ugursayar/r4_mecanum_base/r4_mecanum_base.ino

/*
 * r4_mecanum_base — Arduino Uno R4 WiFi mecanum rover driven by a Nesso N1 handheld.
 * ===========================================================================
 * The drive logic is a port of an earlier Arduino Uno Q build of the same chassis (not published), which
 * runs the same 4-wheel mecanum chassis on an Arduino Uno Q. What changed and why:
 *
 *   * TRANSPORT. The Uno Q build received NessoLink frames over the Router Bridge from a
 *     Linux MPU that owned the radio; there is no MPU here, so this sketch owns the
 *     link itself — Wi-Fi (UDP + TCP) and Bluetooth LE, auto-pairing with whichever
 *     remote speaks first. The dual-link state machine is taken from
 *     the NessoLink `Nesso_R4_Receiver` example.
 *   * NO VISION. The Uno Q build's MODE_AUTO chased objects detected by a camera on the
 *     MPU, gated by a host-side ARM toggle. Neither exists on a bare R4, so MODE_AUTO,
 *     the `vision`/`arm` streams and the arm-expiry failsafe are all gone. With nothing
 *     left to bind to the double-click gesture, mode selection loses its double-click
 *     window too — and with it the ~500 ms commit lag every mode change used to pay.
 *     The secondary stick and the throttle lock are ported in full (the Uno Q build
 *     2026-08-06): a second stick drives whichever everyday mode is NOT selected, so the
 *     two sticks span all three DOFs at once, and a long press locks the throttle axis
 *     instead of selecting a MODE_ROTATE that no longer exists.
 *   * BATTERY. The UPS_3S INA219 pack monitor IS ported (on A4/A5 here, D20/D21 there)
 *     and is INDICATOR-ONLY exactly as on the Uno Q build: it never cuts the motors and never
 *     shuts anything down. The pack's BMS remains the only automatic protection.
 *   * MATRIX. 12x8 here vs the Uno Q's 13x8, both read in PORTRAIT — px() applies the
 *     same 90 deg CW rotation, so an indicator ported from the Uno Q build keeps its geometry
 *     and only the height constant changes.
 *
 * Everything that IS drive logic is carried over unchanged in behaviour: the axis
 * dead-zone / stall-compensation split around the mecanum mix, the per-wheel mixer,
 * the proportional down-scale on overflow, the slew limiter, the click/hold mode
 * gestures and the stale-link stop.
 *
 * BOARD     : Arduino Uno R4 WiFi
 * LIBRARIES : WiFiS3 + Arduino_LED_Matrix (bundled with the R4 core),
 *             NessoLink (github.com/ugursayar/NessoLink),
 *             ArduinoBLE (only when ENABLE_BLE).
 *
 * BLE PREREQUISITES: an up-to-date ESP32-S3 modem firmware on the R4 plus ArduinoBLE.
 * Set ENABLE_BLE 0 for a Wi-Fi-only build with no ArduinoBLE dependency.
 */

#define ENABLE_BLE 1        // 0 = Wi-Fi only (no ArduinoBLE needed)
// TCP is OFF by default and should stay that way unless something actually needs it.
// WiFiS3's `WiFiServer::available()` is a SYNCHRONOUS modem round-trip that performs the
// accept on the ESP32-S3, so with no pending client it waits out the modem's timeout —
// **measured at ~10.1 s on this board**, on every single loop pass. That is 14x
// FAILSAFE_MS, so the rover stops, unpairs, re-pairs on the next buffered datagram and
// does it again 10 s later: with TCP polling on, a UDP link is unusable. The N1's Wi-Fi
// mode is UDP anyway. If TCP is ever needed it must be polled on a slow timer, or moved
// off the drive loop entirely — never called per pass.
#define ENABLE_TCP 0

#include "WiFiS3.h"
#include "Arduino_LED_Matrix.h"
#include <NessoFrame.h>     // portable codec; the library's WiFi transport classes are
                            // ESP32-only, so the Renesas MCU decodes packets itself
#include "arduino_secrets.h"
#include <Wire.h>
#include "INA219.h"         // UPS_3S pack monitor on A4/A5; absent is non-fatal
#include <string.h>
#include <stdlib.h>

#if ENABLE_BLE
#include <ArduinoBLE.h>
#endif

// ── Link config ───────────────────────────────────────────────────────────────
const char*    WIFI_SSID    = SECRET_SSID;
const char*    WIFI_PASS    = SECRET_PASS;
const uint16_t UDP_PORT     = 8889;    // firmware udp_port
const uint16_t TCP_PORT     = 8890;    // firmware tcp_port

// Nesso BLE Nordic-UART service (from the N1 firmware). We subscribe to TX (notify).
const char*    BLE_NAME     = "NESSO";
const char*    BLE_SVC_UUID = "6e400001-b5a3-f393-e0a9-e50e24dcca9e";
const char*    BLE_TX_UUID  = "6e400003-b5a3-f393-e0a9-e50e24dcca9e";

// Search dwell + failsafe timing. The PREFERRED transport gets the long window, the
// other a brief probe: the R4's BLE-central connect momentarily disrupts the N1's own
// Wi-Fi (the N1's C6 also shares one radio), so while unpaired we keep BLE probes short
// and infrequent. The preference is *sticky* — it follows whichever transport last
// paired us — so once you have driven over UDP the R4 stays biased to Wi-Fi.
#define SEARCH_PREFER_BLE 0             // cold-boot preference (0 = Wi-Fi first)
const uint32_t SEARCH_LONG_MS  = 15000; // dwell on the preferred transport
const uint32_t SEARCH_SHORT_MS = 4000;  // brief probe of the other transport
// Fruitless search windows after which the preference stops applying and BOTH transports
// get the long dwell. 2 = one full alternation: the preferred transport has had its long
// window and the other its short probe, and neither produced a frame — so the preference
// is now evidence about the past, not about where the remote is. See searchWindowMs().
const uint8_t  SEARCH_FAIR_AFTER = 2;
// Log any loop iteration slower than this. Sized below FAILSAFE_MS so a stall is reported
// before it is long enough to have dropped the link.
const uint32_t STALL_WARN_MS = 300;
// Reference for the stall detector, cleared by gotoState() so a transport hand-off is not
// reported: those legitimately block for seconds (enterWifi() waits on association, a
// failed BLE.begin() waits out the modem) and stop the motors FIRST, so they cost nothing
// the detector exists to catch. Only unexplained stalls should reach the log, or it becomes
// noise nobody reads.
uint32_t stallRefMs = 0;
// Paired: no valid frame for this long -> treat the link as dead and stop the rover.
// This is the Uno Q build's REMOTE_TIMEOUT (600 ms) rounded to the receiver's own 700 ms
// failsafe so the motors and the "no signal" display agree on when the link is gone.
const uint32_t FAILSAFE_MS     = 700;
const uint32_t UNPAIR_MS       = 3000;  // link lost this long -> re-enter search

// Declared up here, ahead of the first function definition in the file, because the
// Arduino preprocessor injects its auto-generated prototypes immediately before that
// point — a type used in a signature must already exist by then. The state machine that
// uses it lives further down with the transports.
enum LinkState { SEARCH_WIFI, SEARCH_BLE, PAIRED_WIFI, PAIRED_BLE };

ArduinoLEDMatrix matrix;

// ── Motors: 2x L298N, 4 MECANUM wheels, holonomic ─────────────────────────────
// One driver module per axle so the high-current leads stay short; the logic runs are
// the long ones, which is harmless at this PWM rate.
//
// PIN MAP IS IDENTICAL TO the Uno Q build's. That is deliberate and worth keeping: the same
// chassis and the same motor harness can be moved between the Uno Q and this board without
// re-terminating anything, and the two sketches' MOTORS[] tables can be read against each
// other line for line. Verified pin-by-pin against the R4 core before adopting:
//   * analogWrite() is only PWM on D3 D5 D6 D9 D10 D11 (confirmed in the UNOWIFIR4
//     variant's initVariant()) — on every other pin the core silently degrades it to a 0/1
//     digital write, so the four EN pins MUST come from that set. EN sits on
//     D5 D6 D9 D10, all four of which qualify.
//   * D0/D1 (Serial1) and A4/A5 (I2C) are untouched. A4/A5 carry the INA219 pack monitor.
//   * D10-D13 are the SPI bus and D3/D11 are PWM-capable; all are used as plain GPIO here.
//     Nothing on this board needs SPI, and spending a PWM-capable pin on a direction line
//     costs nothing.
//
// ONE R4-SPECIFIC DIFFERENCE, and the only place this map behaves unlike it does on the
// Uno Q: **D13 IS the built-in LED here** (PIN_LED = 13, port P102), whereas the Uno Q build's
// note records that D13 is *not* the onboard LED on an Uno Q. D13 is front-left's second
// direction pin, so the onboard LED now mirrors front-left's direction bit. That is
// cosmetic — the L298N input is high-impedance and the LED sits in parallel — but do not
// read that LED as a status light any more. The variant drives D13 LOW in initVariant()
// before setup() runs, so it boots to a defined state.
//
// Array order is {FL, RL, FR, RR} and must stay that way: drive4() indexes it
// positionally and the mecanum mix assigns a different expression to each corner.
// Reordering these silently turns a strafe into a spin. The order is a geometric fact
// about the chassis, unrelated to which module a motor is wired to.
//
// `inv` flips a motor's sense in software, exactly as swapping its two output leads
// would, so pin order stays natural (IN1 then IN2) on every entry — read the flag, not
// the pin order, to know which way a wheel turns. The values below are a STARTING
// GUESS, not a measurement: they assume the two sides are mirrored by mounting (so one
// whole side must be inverted for the rover to track straight) and that every motor is
// conventionally terminated. Four wheels turning the same absolute direction is the
// wrong state, not the right one — it drives one side backwards.
//
// BRING-UP, in this order — do not skip to the mix:
//   1. Set driveMode = MODE_WHEELTEST below, reflash, and check that the lit matrix
//      quadrant matches the wheel that actually spins. If not, reorder MOTORS[] — never
//      compensate in the mix. Driving forward is invariant to any permutation of the
//      four and rotating only distinguishes left from right, so a front/rear swap within
//      one side passes both those tests and corrupts nothing but strafe. This is the
//      only test that catches it.
//   2. Back in MODE_DRIVE, push the stick forward. Every wheel that turns backwards
//      gets its `inv` flipped. Now the rover tracks straight.
//   3. Only then check strafe, and if it goes the wrong way flip VX_SIGN — not `inv`,
//      which is by now calibrated for forward motion and would break driving straight.
struct Motor { uint8_t in1, in2, en; bool inv; };
// AS ACTUALLY BUILT (wiring confirmed 2026-08-06), and byte-for-byte the Uno Q build's table.
// **L298N#1 = REAR pair, L298N#2 = FRONT pair** — each module sits next to the motors it
// drives, so the high-current leads stay short and only the logic runs are long, which is
// harmless at this PWM rate.
//
// The two modules have OPPOSITE channel conventions: the REAR module is ch A = LEFT /
// ch B = RIGHT, but the FRONT module is ch A = RIGHT / ch B = LEFT. That is why the front
// pair below looks transposed against the rear pair — it is the wiring, not a slip.
//
// `inv` MEASURED on this build 2026-08-06 with MODE_WHEELTEST: all four wheels drove the
// corner the matrix lit (so the array order above is confirmed, and strafe has a correct
// foundation), and all four ran forward except front-right, which was flipped.
//
// The result is the clean symmetric case — the whole LEFT side inverted, the whole RIGHT
// side not — which is what a chassis whose sides are MIRRORED by mounting should give when
// every motor is conventionally terminated. Identical wiring spins mirrored motors in
// opposite *rover* directions, so one whole side must be inverted for the rover to track
// straight; four wheels turning the same absolute direction is the wrong state, not the
// right one.
//
// This is the one place the table DIVERGES from the Uno Q build, which needs front-right
// inverted too. That is not a difference in the chassis or the mix: the Uno Q build's
// front-right leads are terminated the other way round on OUT3/OUT4 relative to its other
// three, and that cable was re-terminated on this build before the R4 went in. `inv`
// belongs to the MOTOR, not the slot — it encodes how these leads are screwed into these
// terminals — so it does not travel with the pin map. If leads are ever re-terminated
// again, re-derive from a wheel test rather than stacking another inversion on top.
Motor MOTORS[4] = {
  {12, 13, 10, true },  // front-left   L298N#2(front)-B: IN3=D12, IN4=D13, ENB=D10 (~)
  { 2,  3,  5, true },  // rear-left    L298N#1(rear) -A: IN1=D2,  IN2=D3,  ENA=D5  (~)
  { 8, 11,  9, false},  // front-right  L298N#2(front)-A: IN1=D8,  IN2=D11, ENA=D9  (~)
  { 4,  7,  6, false},  // rear-right   L298N#1(rear) -B: IN3=D4,  IN4=D7,  ENB=D6  (~)
};

// Sign of the strafe axis as the CHASSIS sees it — RE-MEASURED 2026-08-11 after the
// wheels were remounted in their correct corners.
//
// The mecanum mix below assumes the standard X roller layout (viewed from above, the top
// rollers form an X: FL/RR at +45 deg, FR/RL at -45 deg). With the wheels mounted
// correctly this chassis IS that layout, so the sign is +1.
//
// History: this was -1, measured 2026-08-06 — but that measurement was taken with the
// mecanum wheels mounted in the WRONG corners, which mirrors the roller pattern the
// chassis presents. Remounting them flipped the strafe direction, and only the strafe:
// forward is invariant to roller orientation and rotation needed no change, which is
// exactly the signature of a roller-pattern flip rather than a wiring fault. The
// "this chassis's rollers are mirrored by design" story the old comment told was an
// artifact of the mis-mounted wheels — and the Uno Q build carries the same negation on the
// same chassis, so ITS -1 is suspect for the same reason and should be re-checked on
// hardware before being trusted again.
//
// One sign covers the diagonals as well, since the roller pattern is global. It lives
// HERE and nowhere else, which is what lets everything upstream — the matrix dot,
// dirName(), the serial log — read `vx` as "+ = the rover slides right".
//
// Do NOT "fix" a strafe fault with the `inv` flags: they are calibrated for forward motion
// and would break straight tracking.
const int VX_SIGN = +1;

// ── Drive tuning (PWM units, 0..255) ──────────────────────────────────────────
const int MIN_PWM   = 60;   // below this the motors stall; commands snap up to this
const int MAX_PWM   = 255;  // full speed available
// Belt-and-braces as of NessoLink 1.1.2, which makes "a released stick reads exactly 0"
// part of the contract — the N1 dead-zones its sticks before transmitting, confirmed on
// the Uno Q build's wire log 2026-08-06 (the L/R rest offset that read -12 for months now
// reads 0). Older handheld builds settled at +-11..14, and at a smaller deadband those
// counted as a command: the stall snap lifts them to MIN_PWM, and the shaping emits 0 or
// >=MIN_PWM and never anything between, so the rover kept creeping at ~65 PWM after the
// stick was let go until a release happened to land on 0. That was the "sometimes it
// won't stop" bug. Kept at 25 as the only cover against an out-of-date transmitter
// reintroducing it — the error is asymmetric (too wide only trims centre travel, too
// narrow lets the rover creep away). A non-zero rest reading now means a stale handheld
// build, not normal jitter.
const int REMOTE_DEADBAND = 25;   // applies to BOTH sticks — aux is the same -255..255 scale
const int SLEW_STEP       = 40;   // max PWM change per drive tick (smooth accel/brake ramp)
// The Uno Q build ran its whole loop at this period. Here the same period is a *timer*: the
// transport has to be polled continuously (there is no Bridge thread feeding frames in
// the background any more), and a blocking delay() long enough to matter drops UDP
// datagrams and starves the BLE stack. Driving on a tick keeps SLEW_STEP meaning what
// it meant — max PWM change per 60 ms — while the radio is serviced every pass.
const uint32_t DRIVE_TICK_MS = 60;

// ── Mecanum drive modes ───────────────────────────────────────────────────────
// The wheels are MECANUM, so the rover is holonomic: it can translate sideways without
// rotating. That needs all four wheels driven independently — a skid-steer mixer (both
// left wheels together, both right wheels together) cannot strafe at all, because
// strafing requires the front and rear wheels of one side to turn OPPOSITE ways. All
// four must therefore be working; one dead wheel does not merely weaken a strafe, it
// turns it into a veer.
//
// The N1's drive stick gives two axes and pre-mixes them into tank values, so a
// one-stick remote cannot reach all three DOFs at once — hence modes, cycled by the
// stick click, each re-using the same two axes for a different pair of DOFs. A N1 with a
// second stick fitted lifts exactly that limit (see SECONDARY STICK below), so modes are
// ONE-STICK machinery: with two sticks the mapping is fixed, the click cycle is disabled
// and the mode is pinned to DRIVE — the click then only serves the throttle-lock escape
// (and the WHEELTEST exit).
//
// MODE_WHEELTEST spins one wheel at a time in MOTORS[] index order and lights the matrix
// quadrant the code BELIEVES that index sits in — step 1 of bring-up above.
enum DriveMode : uint8_t { MODE_DRIVE = 0, MODE_STRAFE, MODE_WHEELTEST, MODE_COUNT };
// HOW THE MODES ARE SELECTED — one button, two gestures
//   single click  — clear the throttle lock if it is set (that is all it does); otherwise
//                   cycle the first MODE_CYCLE_COUNT modes: DRIVE -> STRAFE -> DRIVE, and
//                   from ANY off-cycle mode, back to DRIVE. So a click is always the way
//                   out of wherever a gesture put you, in exactly one step.
//   long press    — set the THROTTLE LOCK on the current mode (idempotent: holding again
//                   while locked is a no-op, not a toggle. "Hold = lock" is a simpler
//                   thing to remember mid-drive than a toggle whose result depends on
//                   where you already are, and the click out is unambiguous either way.)
//   reflash only  — MODE_WHEELTEST
// Only the two everyday driving modes are on the CYCLE, so clicking round can never land
// on anything that behaves unexpectedly; giving up an axis costs its own deliberate
// gesture. The off-cycle mode sits AFTER the cycled pair in the enum precisely so the
// cycle can be a prefix (`% MODE_CYCLE_COUNT`) — keep that ordering, and keep DRIVE at 0,
// since a click from an off-cycle mode falls back to it.
//
// MODE_ROTATE USED TO BE A MODE HERE and was replaced by the throttle lock, following
// the Uno Q build 2026-08-06. It was `vy = 0, w = turn` — which is DRIVE with the throttle
// forced to zero, i.e. one specific case of the lock. Generalising it costs nothing and
// gains the missing half: STRAFE with the throttle locked (slide sideways without
// creeping forward) had no way to be expressed before. The gesture, the idempotency and
// the click-out are all unchanged; what changed is that "hold" now means "drop the
// throttle axis" rather than "go to a particular mode", so it composes with the mode
// instead of replacing it. Nothing was lost: DRIVE + lock IS the old ROTATE, bit for bit.
//
// MODE_WHEELTEST keeps no gesture at all — it is reached by setting `driveMode`'s initial
// value below and reflashing. It ignores the stick and spins wheels on a timer, so
// landing on it mid-drive means the rover moves off with the stick centred; a bench
// diagnostic you need after rewiring should cost a reflash, not a slip of the thumb.
//
// The Uno Q build has a third gesture, the double click, which selects its vision mode. There
// is no vision here and nothing else worth a gesture, so the double click is gone — and
// with it the reason a single click had to sit in a 500 ms window before committing,
// waiting to find out whether a partner click was coming. Clicks commit on the release.
const uint8_t MODE_CYCLE_COUNT = 2;      // DRIVE, STRAFE — the click cycle, and only it
// How long the button must be held to count as a long press. Clear of a careless click
// below it, and eight link samples long — the N1 samples its buttons into a frame at
// ~10 Hz, so the threshold is never decided by one lucky frame.
const uint32_t LONGPRESS_MS  = 800;
const int      WHEELTEST_PWM = 200;      // pre-stallComp; brisk enough to be unmistakable
// Each wheel gets a SLOT, of which it spins for the first part and the rover is completely
// still for the rest. The gap is not padding — it is what makes "one wheel at a time"
// legible: without it you are watching for the moment one wheel stops and the next starts,
// and between FL and RL (both on the same side, a hand's width apart) that is exactly the
// distinction the test exists to resolve. With a still gap you count four unambiguous
// events instead.
const uint32_t WHEELTEST_MS      = 2000; // slot per wheel
const uint32_t WHEELTEST_SPIN_MS = 1400; // ...of which this much is spinning
const char*    WHEEL_NAMES[4] = { "FL front-left", "RL rear-left",
                                  "FR front-right", "RR rear-right" };
// Boot straight into the wheel-identification test. This is the ONLY way in — the test has
// no gesture on purpose, because it ignores both sticks and spins wheels on a timer, so
// landing on it mid-drive would mean the rover moves off with the sticks centred. A bench
// diagnostic you need after rewiring should cost a reflash, not a slip of the thumb. One
// click of the stick button leaves it for DRIVE (it is an off-cycle mode), so a paired
// remote can still escape without reflashing.
#define START_IN_WHEELTEST 0
uint8_t driveMode = START_IN_WHEELTEST ? MODE_WHEELTEST : MODE_DRIVE;
const NessoButton MODE_BUTTON = NESSO_BTN_STICK;   // click / hold — see above

// ── Throttle lock ─────────────────────────────────────────────────────────────
// Forces the forward/back axis to zero, leaving the mode's OTHER axis live. It is
// orthogonal to the mode rather than being one — hold in DRIVE and you can only rotate
// (the old MODE_ROTATE, exactly); hold in STRAFE and you can only slide sideways.
//
// Why it is worth a gesture at all: both are precision manoeuvres you can already perform
// by holding the throttle centred, and the lock just stops you creeping while you
// concentrate on the other axis. That is why it is a hold rather than a cycle position —
// useful when aiming, in the way when driving.
//
// It applies to the SUM of both sticks and is applied after the mix inputs are gathered.
// "Throttle locked" therefore means no forward motion can be commanded from anywhere,
// which is the only reading that keeps the matrix indicator honest — a second stick that
// could still drive forward would make the lock mean "locked, unless you use the other
// stick", which is not a lock.
bool throttleLock = false;

// ── Secondary stick: full holonomy with a FIXED mapping — no modes involved ───
// The N1 can carry up to three joysticks (drive seesaw + Mini JoyC + Unit JoyStick2).
// NessoLink carries the extras as aux stick 1 (auxX/auxY — present in v1 frames already,
// flagged by `hasAux`) and aux stick 2 (v2 frames only, `hasAux2`). This binds AUX
// STICK 1; aux stick 2 is decoded by the library but deliberately left unbound for now.
//
// With a second stick present the mapping is FIXED and does not depend on the mode:
//
//   primary stick (seesaw)     throttle + rotate  -> vy, w
//   secondary stick (aux 1)    throttle + strafe  -> vy, vx
//
// All three DOFs are live at once, so every motion in the README's reference chart —
// diagonals, strafe, and all four rotation types including the axle pivots — is
// available BY DEFAULT with no mode change. Modes exist only because ONE stick cannot
// express three DOFs; with two sticks there is nothing left to select, so DRIVE/STRAFE
// are one-stick machinery and a two-stick handheld pins the mode to DRIVE (see
// updateMode()). This port originally had the aux stick drive "whichever mode is not
// selected" instead — the same motions were reachable, but the sticks swapped roles
// when the mode changed, which bought nothing over a fixed mapping and made what a
// stick does depend on a dot on the matrix. Removed 2026-08-11.
//
// The THROTTLE LOCK composes with this: it zeroes vy after both sticks are summed, so
// lock + two sticks gives rotate on the primary and strafe on the secondary — two live
// axes, no forward creep.
//
// NESSO_BTN_STICK2 (the aux stick's own click) is deliberately left unbound — a second
// button that also changed state would make "which stick did I just click?" part of the
// answer, and the gesture set on the drive stick is already at its limit.
//
// The two sticks' contributions SUM and are then clamped, so the shared throttle axis
// adds where they agree and cancels where they fight. Cancelling is the honest result of
// a summed input and the only sane answer to two sticks commanding opposite throttles.
//
// `hasAux` is honoured rather than inferred from a non-zero reading: the encoder zeroes
// the aux fields, so 0/0 cannot distinguish "no stick" from "stick centred". Note the N1
// may ALREADY be setting it if a Mini JoyC is fitted — v1 has always had an aux slot — so
// this can change how an existing handheld drives, not just a future one.
//
// AXIS CONVENTION — specified by the protocol, so this file makes no assumptions.
// NessoLink 1.1.2 states it normatively (see the library's NessoFrame.h): every axis in
// the frame, motors and aux alike, is -255..255; `auxX` is screen-HORIZONTAL with
// positive = RIGHT; `auxY` is screen-VERTICAL with positive = UP. A released stick reads
// exactly 0 — the transmitter applies its own dead zone. "Screen-relative" means the
// TRANSMITTER has already normalised for its display orientation and for how each stick
// module is physically mounted, so this end just reads right/up and does nothing else:
// no sign flip, no swap, no rescale, and deliberately no AUX_X_SIGN / AUX_Y_SIGN knob.
//
// That contract was written down *because* the Uno Q build got it wrong first. Before 1.1.2
// the header specified no aux range and no axis convention, so both had to be guessed —
// and both guesses were wrong: the N1 was transmitting the axes TRANSPOSED (pushing the
// stick up strafed the rover right), because its aux path skipped the orientation flags
// its drive path applied, and its own on-screen joystick disc rendered from the same
// transposed pair — so the handheld looked correct while the wire was swapped. It was
// also sending aux at +-515, the joystick module's raw ADC span, against +-255 for the
// motors. Both were fixed in the TRANSMITTER, not in any receiver: a receiver cannot know
// how a handheld's modules are mounted, so compensating locally would have left every
// other NessoLink receiver still swapped and would have inverted this one the moment the
// transmitter was fixed. Same rule as VX_SIGN in the mix — a correction belongs where the
// fact it corrects lives. If an axis is wrong, fix the transmitter.


// ── Link state ────────────────────────────────────────────────────────────────
// (enum LinkState is declared with the link config at the top — see the note there.)
LinkState linkState      = SEARCH_WIFI;
uint32_t  stateEnteredMs = 0;
uint32_t  lastFrameMs    = 0;
bool      preferBle      = SEARCH_PREFER_BLE;  // sticky: follows the last transport that paired

// Length of the current search window — the preferred transport dwells longer.
// Search windows completed since the last successful pair. Resets in acceptFrame().
uint8_t searchRounds = 0;

uint32_t searchWindowMs() {
  // THE PREFERENCE DECAYS. It is a tie-breaker for the first couple of windows, not a
  // standing bias — because the thing it is biased toward is whatever worked LAST time,
  // and the most common reason a paired link stops is that the operator moved the handheld
  // to the OTHER transport. Held indefinitely, the preference then votes for the transport
  // that just went away: after pairing over BLE it gave BLE 15 s and Wi-Fi only 4 s, and
  // that 4 s had to cover a possibly-slow reconnect before any listening could happen.
  // Observed on hardware 2026-08-06 — switching the N1 from BLE to Wi-Fi UDP did not
  // reconnect at all until the R4 was power-cycled (which cleared preferBle to its
  // cold-boot default).
  //
  // So once both transports have had their turn and neither produced a frame, stop
  // favouring and give each a full window. The fast re-pair on the usual transport is
  // preserved for the case it is meant for — a brief dropout on the SAME transport, which
  // is resolved inside the first window or two.
  if (searchRounds >= SEARCH_FAIR_AFTER) return SEARCH_LONG_MS;
  bool onWifi = (linkState == SEARCH_WIFI);
  return (onWifi != preferBle) ? SEARCH_LONG_MS : SEARCH_SHORT_MS;   // preferred -> long
}

// ── Shared drive state, written by whichever transport delivered the frame ────
int      remoteL = 0, remoteR = 0;
int      remoteAuxX = 0, remoteAuxY = 0;   // aux stick 1; -255..255, +X = right, +Y = up
bool     remoteHasAux = false;
uint16_t remoteBtns = 0;
bool     haveFrame = false;

// Bound Wi-Fi remote (source-lock): once paired we only trust this origin.
IPAddress boundIp(0, 0, 0, 0);
char      pairLabel[24] = "";

static inline bool isPaired() { return linkState == PAIRED_WIFI || linkState == PAIRED_BLE; }

// ── Motor primitives ──────────────────────────────────────────────────────────
// Shape a raw remote axis onto the usable band. The dead-zone and the MIN_PWM stall snap
// happen on OPPOSITE sides of the mecanum mix, which is why this is two functions and
// not one:
//   * axisDead() runs on the INPUT axes. Rescales [DEADBAND..full] -> [0..255] linearly.
//   * stallComp() runs on each mixed WHEEL value. Rescales [1..255] -> [MIN_PWM..MAX_PWM].
// Snapping to MIN_PWM before mixing would be wrong: it would inject a 60-unit floor into
// every axis, so a pure-forward command would leak a phantom strafe/rotate term and the
// rover would crab instead of tracking straight.
int axisDead(int v) {
  int s = (v < 0) ? -1 : 1, m = abs(v);
  if (m <= REMOTE_DEADBAND) return 0;
  long out = (long)(m - REMOTE_DEADBAND) * 255 / (255 - REMOTE_DEADBAND);
  return s * (int)out;
}
// Clamp an AXIS — not a wheel value — to the -255..255 band that the mecanum mix, the
// matrix dot and dirName() all assume. Needed once two sticks can feed the same axis: a
// summed throttle reaches +-510, which would push showDir()'s dot off the panel and hand
// the ratio between the axes to the wheel-overflow rescale below instead of to the
// operator. Used on the raw aux input too, where it is a MALFORMED-FRAME GUARD and not a
// rescale — the field is int16, so a bad or hostile frame could otherwise inject +-32767
// into the mix, which the wheel-overflow rescale would treat as a legitimate full-scale
// command and divide every other axis down against. It is a no-op for anything in spec.
int clampAxis(int v) { return (v > 255) ? 255 : ((v < -255) ? -255 : v); }
int stallComp(int v) {
  if (v == 0) return 0;
  int s = (v < 0) ? -1 : 1, m = abs(v);
  if (m > 255) m = 255;
  long out = (long)(m - 1) * (MAX_PWM - MIN_PWM) / 254 + MIN_PWM;
  return s * (int)out;
}
int slew(int cur, int target) {             // ramp cur toward target by at most SLEW_STEP
  if (target > cur) return (target - cur > SLEW_STEP) ? cur + SLEW_STEP : target;
  if (target < cur) return (cur - target > SLEW_STEP) ? cur - SLEW_STEP : target;
  return cur;
}
void setMotor(const Motor& m, int v) {
  if (v > 255) v = 255; if (v < -255) v = -255;
  if (m.inv) v = -v;             // clamp first: -(-255) is in range, -(-256) would not be
  if (v >= 0) { digitalWrite(m.in1, HIGH); digitalWrite(m.in2, LOW); }
  else        { digitalWrite(m.in1, LOW);  digitalWrite(m.in2, HIGH); v = -v; }
  analogWrite(m.en, v);
}
// Per-wheel, not per-side: a drive(left, right) mixer feeds both left wheels the same
// value and both right wheels the same value, which is skid steer and can never strafe.
// Index order matches MOTORS[]: {FL, RL, FR, RR}.
void drive4(const int w[4]) {
  for (int i = 0; i < 4; i++) setMotor(MOTORS[i], w[i]);
}

int curPwm[4] = {0, 0, 0, 0};   // last values written; the slew limiter's state

// Cut the motors NOW, skipping the ramp, and forget where the ramp had got to. Called
// before anything that stops servicing the drive tick — every transport transition takes
// the radio down and enterWifi() blocks for up to nine seconds, during which the last
// PWM values would otherwise stand. A ramp is a comfort feature for a rover under
// command; a rover whose commands have stopped arriving should not be ramping anywhere.
void stopMotors() {
  const int zero[4] = {0, 0, 0, 0};
  drive4(zero);
  for (int i = 0; i < 4; i++) curPwm[i] = 0;
}

// ── LED matrix — PORTRAIT, rotated 90 deg CW on the way out ───────────────────
// The panel is physically 12 columns x 8 rows landscape, but the rover is read with the
// board turned, so every routine below draws in a LOGICAL 8x12 PORTRAIT frame and px()
// applies the rotation. Logical (0,0) is the TOP-LEFT as seen by the viewer, +x is right
// and +y is DOWN. Nothing above fbRender() should touch fb[][] directly.
//
// This is the same arrangement the Uno Q build uses (its panel is 13x8, so its logical frame
// is 8x13); keeping the two in the same orientation means an indicator ported from there
// keeps its geometry and only its height constant changes.
//
// The frame is banded, and the bands do not overlap:
//   y = 0        STATUS   — link + mode                        (showDir)
//   y = 2..H-3   STICK    — the proportional dot; its plus spans y = 1..H-2
//   y = H-1      BATTERY  — pack gauge                         (showDir)
const int PANEL_ROWS = 8, PANEL_COLS = 12;   // physical
const int W = 8, H = 12;                     // LOGICAL, post-rotation: 8 wide, 12 tall
uint8_t fb[PANEL_ROWS][PANEL_COLS];
uint8_t lastFB[PANEL_ROWS][PANEL_COLS];
bool    haveLast = false;

// Which way the panel is turned relative to the logical frame. 1 = the 90 deg CW mapping
// the Uno Q build uses; 0 = the other way round. This is a PHYSICAL fact about how the board is
// mounted on the rover, so it lives in exactly one place — like VX_SIGN. If the whole
// display comes out upside down (status row along the wrong edge, forward reading as
// backward), flip THIS, never the individual draw routines: they are all in logical
// coordinates and are correct relative to each other.
#define MATRIX_ROTATE_CW 1

static inline void fbClear() { memset(fb, 0, sizeof(fb)); }
// Logical -> physical. CW: logical +x (right) becomes physical +row and logical +y (down)
// becomes physical -col. W is the physical row count and H the physical column count,
// which is why the logical frame is 8x12 and not 12x8.
static inline void px(int x, int y) {
  if (x < 0 || x >= W || y < 0 || y >= H) return;
#if MATRIX_ROTATE_CW
  fb[x][H - 1 - y] = 1;
#else
  fb[W - 1 - x][y] = 1;
#endif
}
void fbRender() {
  if (haveLast && memcmp(fb, lastFB, sizeof(fb)) == 0) return;   // skip identical redraws
  matrix.renderBitmap(fb, PANEL_ROWS, PANEL_COLS);
  memcpy(lastFB, fb, sizeof(fb));
  haveLast = true;
}

// Proportional "virtual stick" indicator: a plus-shaped dot whose position encodes
// throttle (up = forward) and lateral command (right = right); dead-centre = stopped.
// The horizontal axis shows whichever DOF the current mode steers with, so the dot keeps
// meaning "where the stick is" in every mode. That relies on `vx` and `w` both being in
// the OPERATOR's frame (+ = right) all the way down to here — the chassis's roller
// mirroring is applied in the mix via VX_SIGN, not to the axes.
//
// TOP ROW (y=0) — connection on the left, mode on the right:
//   x=0 lit = paired over Wi-Fi,  x=1 lit = paired over BLE
//   right edge = mode, 1..MODE_COUNT dots from x=W-1 leftwards:
//               1 = DRIVE, 2 = STRAFE, 3 = WHEELTEST
// Three dots stop at x=5, so the two groups can never run together.
//
// BOTTOM ROW (y=H-1) — battery gauge, 1..W pixels. Always lights at least one pixel while
// the INA219 is readable, so an EMPTY bottom row means "no sensor" and never "flat pack".
// Those are opposite states: a missing sensor deliberately disables battery management and
// leaves the rover driving, so they must not look alike.
//
// The THROTTLE LOCK is drawn by changing the dot's SHAPE rather than by claiming another
// pixel: locked, it loses its vertical arms and becomes a horizontal bar. That is the
// indicator describing itself — the arms it drops are the axis it gave up — and it reads
// at a glance from the shape alone, which a lone extra status pixel would not. It also
// cannot be confused with "throttle merely centred": that is a plus sitting on the centre
// row, this is a bar.
void showDir(int vy, int vx, int w, bool viaBle, uint8_t mode, bool lock,
             float pct, bool battOk, bool lowWarn) {
  fbClear();

  // TOP ROW — link + mode
  px(viaBle ? 1 : 0, 0);
  for (uint8_t i = 0; i <= mode && i < MODE_COUNT; i++) px(W - 1 - i, 0);

  // BOTTOM ROW — battery gauge
  if (battOk) {
    int cols = 1 + (int)(pct / 100.0f * (W - 1) + 0.5f);
    if (cols > W) cols = W;
    if (cols < 1) cols = 1;
    for (int i = 0; i < cols; i++) px(i, H - 1);
  }
  // Low-battery blink at the far end of the gauge row. It only collides with the gauge
  // itself at ~100% charge, which cannot be true while the warning is latched.
  if (lowWarn && (millis() / 500) % 2) px(W - 1, H - 1);

  // MIDDLE BAND — the stick dot. The centre is clamped to y = 2..H-3 so the plus can
  // never bleed into the status row above or the battery row below.
  int lat = (vx != 0) ? vx : w;               // -255..255  right(+) / left(-)
  int x   = (lat + 255) * (W - 1) / 510;      // 0..W-1
  int y   = 2 + (255 - vy) * (H - 5) / 510;   // 2..H-3  (forward = top)
  px(x, y); px(x - 1, y); px(x + 1, y);              // horizontal bar — always
  if (!lock) { px(x, y - 1); px(x, y + 1); }         // vertical arms — only unlocked
  fbRender();
}

// Light the 3x3 quadrant matching MOTORS[idx]'s *assumed* corner, while that wheel — and
// only that wheel — spins. If the lit corner and the spinning wheel disagree, the array
// order is wrong and strafe cannot work; fix the order, never the mecanum signs.
void showWheelTest(int idx) {
  fbClear();
  int x0 = (idx == 0 || idx == 1) ? 0 : W - 3;   // {FL,RL} left  | {FR,RR} right
  int y0 = (idx == 0 || idx == 2) ? 0 : H - 3;   // {FL,FR} front | {RL,RR} rear
  for (int dx = 0; dx < 3; dx++)
    for (int dy = 0; dy < 3; dy++) px(x0 + dx, y0 + dy);
  fbRender();
}

// Blinking battery outline with a proportional fill — shown instead of the stick dot once
// the pack is critically low, so the state is unmistakable from across the room. It takes
// the whole panel, status and gauge rows included: at this point there is nothing more
// important for the panel to be saying.
void showBattery(float pct) {
  fbClear();
  if ((millis() / 500) % 2) {
    px(3, 0); px(4, 0);                                              // terminal (top)
    for (int x = 1; x <= 6; x++) { px(x, 1); px(x, H - 1); }          // body top/bottom
    for (int y = 1; y <= H - 1; y++) { px(1, y); px(6, y); }          // body sides
    int rows = (int)(pct / 100.0f * (H - 3) + 0.5f);                  // interior y = 2..H-2
    if (rows > H - 3) rows = H - 3;
    for (int i = 0; i < rows; i++)                                    // fills from the bottom
      for (int x = 2; x <= 5; x++) px(x, H - 2 - i);
  }
  fbRender();
}

// Searching animation. Top block lit on the left = scanning Wi-Fi, on the right = BLE.
// A short bar sweeps DOWN the tall axis below it.
void drawSearch(bool ble) {
  fbClear();
  if (!ble) { for (int x = 0; x < 3; x++) px(x, 0); }
  else      { for (int x = W - 3; x < W; x++) px(x, 0); }
  int sweep = 2 + (int)((millis() / 120) % (H - 3));
  px(3, sweep); px(4, sweep);
  fbRender();
}

// Link-loss indicator: a full-panel X. The rover is stopped whenever this is showing.
void drawNoSignal() {
  fbClear();
  for (int y = 0; y < H; y++) {
    int x1 = y * (W - 1) / (H - 1);
    px(x1, y);
    px(W - 1 - x1, y);
  }
  fbRender();
}

// ── Battery: UPS_3S (3x 18650 in series) via INA219 @ 0x41 on Wire (A4/A5) ────
// Ported from the Uno Q build 2026-08-06, thresholds and state machine unchanged.
//
// Thresholds are on the *pack* voltage (bus + shunt drop), smoothed by an EMA: the motors
// draw from the same pack, so a stall sags the rail well below the true state of charge.
// tau ~= 20 s at 1 Hz rides out any sag short of an actually flat battery, so a brief sag
// can never trip the display while a real decline still shows within ~30 s.
//
// INDICATOR-ONLY, exactly as on the Uno Q build: this does NOT cut the motors and does not shut
// anything down. The pack's own BMS is the only automatic protection. The consequence,
// stated plainly because it is a real trade: a flat pack under motor load will be dragged
// to BMS cutoff if the operator ignores the panel.
//
// The failsafe direction here is the OPPOSITE of the link's, deliberately. An absent or
// failed INA219 reports state -1 and leaves the rover driving, because losing a *sensor*
// must not immobilise the rover — whereas losing contact with the *operator* must never
// leave it driving. Do not "make them consistent".
INA219 ina;

const float V_MIN     = 9.0f;    // 3.0 V/cell — pack empty (0 %)
const float V_MAX     = 12.6f;   // 4.2 V/cell — pack full (100 %)
const float V_WARN    = 9.6f;    // ~17 % — advisory only (blinking gauge-row pixel)
const float V_CRIT    = 9.3f;    // ~8 %  — full-panel battery display; no action taken
const float V_RELEASE = 10.5f;   // critical latch clears only once clearly recharged
const float WARN_HYST = 0.15f;   // warn releases at V_WARN + this

const uint32_t BATT_SAMPLE_MS = 1000;
const uint32_t BATT_REPORT_MS = 5000;    // serial cadence; the Uno Q build pushed this to its MPU
const uint32_t BATT_RETRY_MS  = 5000;    // re-probe cadence while the module is absent
const uint32_t EMA_RESEED_MS  = 30000;   // gap after which the carried EMA is stale
const float    EMA_ALPHA      = 0.05f;   // tau ~= 20 s at 1 Hz
const int      LOW_CONFIRM    = 10;      // consecutive samples before a state change

// -1 = sensor absent, 0 = ok, 1 = warn, 2 = critical. -1 is the failsafe (see above).
int   battState  = -1;
bool  battReady  = false;    // INA219 has answered at least once
bool  battSeeded = false;    // battEma holds a real value (survives an I2C dropout)
float battEma = 0.0f, battPct = 0.0f, battV = 0.0f, battI = 0.0f;
bool  battCrit = false;      // latched
bool  battWarn = false;
int   critCount = 0, relCount = 0, warnCount = 0, warnClearCount = 0;
uint32_t lastGoodMs = 0;     // millis() of the last successful sample

float pctFromV(float v) {
  float p = (v - V_MIN) / (V_MAX - V_MIN) * 100.0f;
  if (p > 100.0f) p = 100.0f;
  if (p < 0.0f)   p = 0.0f;
  return p;
}
void resetBattCounters() { critCount = relCount = warnCount = warnClearCount = 0; }

void reportBattery(uint32_t now) {
  static uint32_t lastReport = 0;
  if (now - lastReport < BATT_REPORT_MS) return;
  lastReport = now;
  if (battState < 0) { Serial.println("[batt] no sensor"); return; }
  Serial.print("[batt] "); Serial.print(battEma, 2); Serial.print("V ");
  Serial.print(battPct, 0); Serial.print("% ");
  Serial.print(battI, 0);   Serial.print("mA state=");
  Serial.println(battState);
}

void pollBattery(uint32_t now) {
  static uint32_t lastSample = 0, lastRetry = 0;

  if (!battReady) {                       // (re)probe — the module may be off at boot
    reportBattery(now);                   // keep saying we are blind
    if (now - lastRetry < BATT_RETRY_MS) return;
    lastRetry = now;
    // Timed: an I2C probe of an ABSENT device can block on bus timeouts, and anything that
    // blocks longer than FAILSAFE_MS silently drops the radio link. Reported so a stall is
    // visible rather than inferred from mysterious unpairs.
    uint32_t probeT0 = millis();
    bool probeOk = ina.begin();
    uint32_t probeMs = millis() - probeT0;
    if (probeMs > 50) {
      Serial.print("[batt] probe blocked "); Serial.print(probeMs); Serial.println(" ms");
    }
    if (!probeOk) { battState = -1; return; }
    battReady = true;
    resetBattCounters();                  // a confirmation streak must not span a data gap
    Serial.println("[batt] INA219 @ 0x41 online");
  }

  if (now - lastSample < BATT_SAMPLE_MS) return;
  lastSample = now;

  float packV, busV, mA, W_;
  if (!ina.sample(packV, busV, mA, W_)) {
    Serial.println("[batt] INA219 read failed - re-probing");
    battReady = false;
    battState = -1;
    lastRetry = now;
    resetBattCounters();
    return;
  }

  battV = packV;
  battI = mA;
  // Carry the smoothed value across a short I2C dropout. Re-seeding from a single raw
  // sample would throw away the sag immunity the EMA exists for — and the event most
  // likely to glitch the bus (a stall brownout) is exactly the event that produces a
  // sagged reading, so a reseed there could latch CRITICAL on a half-full pack. Only
  // reseed when the gap was long enough that the old value is genuinely stale.
  if (!battSeeded || now - lastGoodMs > EMA_RESEED_MS) {
    battEma = packV;
    battSeeded = true;
    resetBattCounters();
  } else {
    battEma = EMA_ALPHA * packV + (1.0f - EMA_ALPHA) * battEma;
  }
  lastGoodMs = now;
  battPct = pctFromV(battEma);

  // Critical: latched, so the panel does not flicker between critical and normal as the
  // rail sags and recovers under motor load. Both the smoothed AND the instantaneous
  // voltage must be low: the EMA is the slow guard against a stall sag, and the raw
  // sample is a fast veto that clears the streak as soon as the rail recovers — so a
  // freshly re-seeded EMA cannot walk into a latch.
  if (!battCrit) {
    if (battEma < V_CRIT && packV < V_CRIT) {
      if (++critCount >= LOW_CONFIRM) {
        battCrit = true;
        Serial.println("[batt] CRITICAL - indicator only, no action taken");
      }
    } else critCount = 0;
  } else {
    if (battEma > V_RELEASE) {
      if (++relCount >= LOW_CONFIRM) { battCrit = false; relCount = 0; critCount = 0; }
    } else relCount = 0;
  }

  // Warning: advisory, with hysteresis so it does not flicker at the threshold.
  if (!battWarn) {
    if (battEma < V_WARN) { if (++warnCount >= LOW_CONFIRM) { battWarn = true; warnCount = 0; } }
    else warnCount = 0;
  } else {
    if (battEma > V_WARN + WARN_HYST) { if (++warnClearCount >= LOW_CONFIRM) { battWarn = false; warnClearCount = 0; } }
    else warnClearCount = 0;
  }

  battState = battCrit ? 2 : (battWarn ? 1 : 0);
  reportBattery(now);
}

// ── Pairing: accept a decoded frame from any transport ────────────────────────
// origin is a source IP for UDP (used for source-lock); TCP/BLE pass 0.0.0.0.
void acceptFrame(const NessoFrame& f, IPAddress origin, bool viaBle, const char* kind) {
  bool searching = !isPaired();

  if (!searching && !viaBle && linkState == PAIRED_WIFI &&
      boundIp != IPAddress(0, 0, 0, 0) && origin != IPAddress(0, 0, 0, 0) &&
      origin != boundIp) {
    return;   // source-lock: ignore a *different* Wi-Fi remote while paired
  }

  if (searching) {
    preferBle    = viaBle;   // sticky: bias future searches to whatever just worked...
    searchRounds = 0;        // ...but only until it has been given a fair chance and failed
    boundIp      = origin;
    if (origin != IPAddress(0, 0, 0, 0))
      snprintf(pairLabel, sizeof(pairLabel), "%s %d.%d.%d.%d", kind,
               origin[0], origin[1], origin[2], origin[3]);
    else
      snprintf(pairLabel, sizeof(pairLabel), "%s", kind);
    linkState      = viaBle ? PAIRED_BLE : PAIRED_WIFI;
    stateEnteredMs = millis();
    Serial.print(">>> PAIRED via "); Serial.println(pairLabel);
  }

  remoteL       = f.leftMotor;
  remoteR       = f.rightMotor;
  remoteAuxX    = f.auxX;
  remoteAuxY    = f.auxY;
  remoteHasAux  = f.hasAux;
  remoteBtns    = f.buttons;
  haveFrame     = true;
  lastFrameMs   = millis();
}

// ── TCP stream reassembly (TCP has no packet boundaries) ──────────────────────
// Resynchronises on the 0xA5 magic and uses the version byte for the length. Kept compiled
// out by default — see ENABLE_TCP at the top for why. The re-assembly logic is correct and
// worth preserving; it is the *polling* that is unaffordable.
#if ENABLE_TCP
struct TcpParser {
  uint8_t buf[96];
  int     n = 0;
  void clear() { n = 0; }
  void feed(const uint8_t* d, int len) {
    for (int i = 0; i < len && n < (int)sizeof(buf); i++) buf[n++] = d[i];
    for (;;) {
      int start = -1;
      for (int i = 0; i < n; i++) if (buf[i] == NESSO_MAGIC) { start = i; break; }
      if (start < 0) { n = 0; break; }
      if (start > 0) { memmove(buf, buf + start, n - start); n -= start; }
      if (n < 2) break;
      uint8_t ver = buf[1];
      int need = (ver == NESSO_PROTO_VER_V1) ? NESSO_FRAME_LEN_V1
               : (ver == NESSO_PROTO_VER_V2) ? NESSO_FRAME_LEN_V2 : -1;
      if (need < 0) { memmove(buf, buf + 1, n - 1); n--; continue; }
      if (n < need) break;
      NessoFrame f;
      if (nessoDecode(buf, need, f)) {
        memmove(buf, buf + need, n - need); n -= need;
        acceptFrame(f, IPAddress(0, 0, 0, 0), false, "TCP");
      } else {
        memmove(buf, buf + 1, n - 1); n--;   // bad CRC — slide past this magic
      }
    }
  }
};
#endif

// ── Wi-Fi transport ───────────────────────────────────────────────────────────
WiFiUDP    udp;
#if ENABLE_TCP
WiFiServer tcpServer(TCP_PORT);
TcpParser  tcpParser;
#endif

bool udpListening = false;   // the sockets are OPEN — not merely "Wi-Fi associated"

// Open the listening sockets, idempotently. Split out of enterWifi() and retried from
// pollWifiFrames() every pass, because binding them ONCE inside enterWifi()'s blocking
// window was a silent single point of failure: if the association had not completed within
// those 9 seconds the sockets were never opened AT ALL, and a Wi-Fi window that associated
// a moment later then sat fully connected and deaf for its entire dwell. Nothing retried
// it — the next window simply re-ran the same 9-second gamble. Coming straight off
// BLE.end() the modem can need longer than 9 s, which is how a handheld switched from BLE
// to Wi-Fi UDP could fail to reconnect indefinitely (observed 2026-08-06; only a power
// cycle cleared it). "Associated" and "listening" are different states, and conflating them
// is what hid this.
void ensureWifiListening() {
  if (udpListening) return;
  if (WiFi.status() != WL_CONNECTED || WiFi.localIP() == IPAddress(0, 0, 0, 0)) return;
  udp.begin(UDP_PORT);
#if ENABLE_TCP
  tcpServer.begin();
  tcpParser.clear();
#endif
  udpListening = true;
  Serial.print("[wifi] listening UDP:"); Serial.print(UDP_PORT);
#if ENABLE_TCP
  Serial.print(" TCP:"); Serial.print(TCP_PORT);
#endif
  Serial.print(" as "); Serial.println(WiFi.localIP());
}

void enterWifi() {
  Serial.print("[wifi] connecting to "); Serial.print(WIFI_SSID); Serial.print(' ');
  WiFi.begin(WIFI_SSID, WIFI_PASS);
  uint32_t t0 = millis();
  while (millis() - t0 < 9000) {
    if (WiFi.status() == WL_CONNECTED && WiFi.localIP() != IPAddress(0, 0, 0, 0)) break;
    drawSearch(false);
    delay(200);
    Serial.print('.');
  }
  Serial.println();
  // Not fatal if the association has not landed: the poll loop picks it up as soon as it
  // does, so a slow modem costs some latency rather than the whole window.
  ensureWifiListening();
  if (!udpListening)
    Serial.println("[wifi] not associated yet - will keep trying inside this window");
}

void exitWifi() {
  udp.stop();
  WiFi.disconnect();
  WiFi.end();
  udpListening = false;
}

void pollWifiFrames() {
  ensureWifiListening();            // no-op once bound; recovers a late association
  if (!udpListening) return;
  int sz = udp.parsePacket();                              // UDP
  if (sz > 0) {
    IPAddress src = udp.remoteIP();
    uint8_t b[NESSO_FRAME_MAX_LEN];
    int want = sz < (int)NESSO_FRAME_MAX_LEN ? sz : (int)NESSO_FRAME_MAX_LEN;
    int n = udp.read(b, want);
    NessoFrame f;
    if (n >= (int)NESSO_FRAME_LEN_V1 && nessoDecode(b, n, f)) {
      acceptFrame(f, src, false, "UDP");
    } else {
      Serial.print("[udp] rx "); Serial.print(sz); Serial.print("B from ");
      Serial.print(src); Serial.println(" - not a valid frame");
    }
  }
#if ENABLE_TCP
  // WARNING: this call blocks ~10 s per pass with no pending client. See ENABLE_TCP.
  WiFiClient client = tcpServer.available();               // TCP
  if (client) {
    uint8_t tmp[64];
    int a = client.available(), i = 0;
    while (a-- > 0 && i < (int)sizeof(tmp)) { int c = client.read(); if (c < 0) break; tmp[i++] = (uint8_t)c; }
    if (i > 0) tcpParser.feed(tmp, i);
  }
#endif
}

// ── BLE transport (central -> NESSO peripheral) ───────────────────────────────
#if ENABLE_BLE
BLEDevice         blePeripheral;
BLECharacteristic bleTxChar;
bool              bleReady = false;
// Did BLE.begin() actually succeed for the window we are in? A failed begin() leaves the
// stack un-started, so scanning it yields nothing and end()-ing it tears down something
// that was never built. Without this the receiver burns a full SEARCH_SHORT_MS window
// staring at a dead radio on every cycle — time it should be spending listening on Wi-Fi,
// which still works. loop() reads it to bail out of the BLE window immediately.
bool              bleBegun = false;

void enterBle() {
  Serial.println("[ble] starting BLE, scanning for \"NESSO\" ...");
  // NOTE: a failed begin() is NOT recoverable in software here. Uploading a sketch resets
  // the RA4M1 but NOT the ESP32-S3, so a reflash taken while BLE was live leaves the modem
  // running the previous firmware's stack and begin() fails against it. `BLE.end()` +
  // `BLE.begin()` was tried on hardware 2026-08-06 and fails identically — it was removed
  // rather than left in, because it recovered nothing and doubled the time each dead BLE
  // window costs. Only a physical power cycle (unplug USB) clears it. Don't re-add the
  // retry without testing it against a genuinely wedged modem.
  bleBegun = BLE.begin();
  if (!bleBegun) {
    // Not necessarily fatal or permanent: the ESP32-S3 survives an RA4M1 reset, so a
    // reflash can leave the modem in whatever state the PREVIOUS firmware left it, and a
    // Wi-Fi/BLE hand-off can land on it mid-transition. Retried on the next BLE window,
    // which the bail-out in loop() rate-limits to one attempt per Wi-Fi dwell. A full
    // power cycle (not just the reset button) is what clears a wedged modem.
    Serial.println("[ble] BLE.begin() failed - staying on Wi-Fi, will retry next window");
    return;
  }
  BLE.scanForUuid(BLE_SVC_UUID);
}

void exitBle() {
  if (!bleBegun) return;                  // nothing was ever started; end() would be a lie
  BLE.stopScan();
  if (blePeripheral && blePeripheral.connected()) blePeripheral.disconnect();
  bleReady = false;
  BLE.end();
  bleBegun = false;
}

// While in SEARCH_BLE: find the peripheral, connect, subscribe to TX notifications.
void pollBleSearch() {
  BLEDevice dev = BLE.available();
  if (!dev) return;
  if (dev.localName() != BLE_NAME && !dev.hasLocalName()) return;
  BLE.stopScan();
  Serial.print("[ble] found "); Serial.print(dev.localName()); Serial.print(" (");
  Serial.print(dev.address()); Serial.println("), connecting");
  if (!dev.connect())            { Serial.println("[ble] connect failed"); BLE.scanForUuid(BLE_SVC_UUID); return; }
  if (!dev.discoverAttributes()) { Serial.println("[ble] discover failed"); dev.disconnect(); BLE.scanForUuid(BLE_SVC_UUID); return; }
  BLECharacteristic tx = dev.characteristic(BLE_TX_UUID);
  if (!tx || !tx.canSubscribe() || !tx.subscribe()) {
    Serial.println("[ble] TX characteristic not subscribable");
    dev.disconnect(); BLE.scanForUuid(BLE_SVC_UUID); return;
  }
  blePeripheral = dev;
  bleTxChar     = tx;
  bleReady      = true;
  Serial.println("[ble] subscribed to TX; waiting for frames");
}

// While connected: pull decoded notifications.
void pollBleConnected() {
  if (!blePeripheral.connected()) { bleReady = false; return; }
  if (bleTxChar.valueUpdated()) {
    uint8_t b[NESSO_FRAME_MAX_LEN];
    int len = bleTxChar.valueLength();
    if (len > (int)NESSO_FRAME_MAX_LEN) len = NESSO_FRAME_MAX_LEN;
    bleTxChar.readValue(b, len);
    NessoFrame f;
    if (len >= (int)NESSO_FRAME_LEN_V1 && nessoDecode(b, len, f))
      acceptFrame(f, IPAddress(0, 0, 0, 0), true, "BLE");
  }
}
bool bleReadyDbg() { return bleReady; }
bool bleBegunDbg() { return bleBegun; }
#else
void enterBle() {}
void exitBle()  {}
void pollBleSearch()    {}
void pollBleConnected() {}
bool bleReadyDbg() { return false; }
bool bleBegunDbg() { return false; }
#endif

// ── Link state machine ────────────────────────────────────────────────────────
static inline bool isWifiDomain(LinkState s) { return s == SEARCH_WIFI || s == PAIRED_WIFI; }

void gotoState(LinkState ns) {
  stopMotors();       // FIRST: a transport swap takes the radio down for seconds
  stallRefMs = 0;     // this hand-off's blocking is expected; don't report it as a stall
  bool wasWifi = isWifiDomain(linkState), willWifi = isWifiDomain(ns);
  if (wasWifi && !willWifi)      { exitWifi(); enterBle(); }
  else if (!wasWifi && willWifi) { exitBle();  enterWifi(); }
  linkState      = ns;
  stateEnteredMs = millis();
  if (ns == SEARCH_WIFI || ns == SEARCH_BLE) {
    boundIp      = IPAddress(0, 0, 0, 0);
    pairLabel[0] = 0;
    remoteBtns   = 0;    // a held button must not survive an un-pair and fire a gesture
  }
  Serial.print("[state] -> ");
  Serial.println(ns == SEARCH_WIFI ? "SEARCH_WIFI" : ns == SEARCH_BLE ? "SEARCH_BLE"
               : ns == PAIRED_WIFI ? "PAIRED_WIFI" : "PAIRED_BLE");
}

// Periodic "still here" tick while searching, so a silent link is visible on Serial.
uint32_t lastBeatMs = 0;
void heartbeat() {
  if (millis() - lastBeatMs < 2000) return;
  lastBeatMs = millis();
  if (linkState == SEARCH_WIFI) {
    uint32_t elapsed = millis() - stateEnteredMs;
    uint32_t win     = searchWindowMs();
    uint32_t leftS   = elapsed < win ? (win - elapsed) / 1000 : 0;
    Serial.print("[search] WiFi - listening UDP:"); Serial.print(UDP_PORT);
#if ENABLE_TCP
    Serial.print(" TCP:"); Serial.print(TCP_PORT);
#endif
    Serial.print(" as "); Serial.print(WiFi.localIP());
    Serial.print(". "); Serial.print(leftS); Serial.println("s left");
  } else {
    Serial.print("[search] BLE - ");
    Serial.println(bleReadyDbg() ? "connected to NESSO, waiting for notifications"
                                 : "scanning for NESSO");
  }
}

// ── Mode gestures ─────────────────────────────────────────────────────────────
// Edges only — the N1 repeats its button state at ~10 Hz, so level-triggering would race
// through every mode while the button is held. Gated on a fresh link so a stale held-down
// button cannot cycle after the link drops.
//
// A click resolves on the RELEASE, not the press. It has to: while the button is still
// down there is no way to know whether it will turn out to be a click or a hold, and
// acting on the press meant a long press first cycled DRIVE->STRAFE and only then became
// ROTATE.
void updateMode(bool linkFresh, uint32_t now) {
  static bool     lastDown  = false;
  static uint32_t pressMs   = 0;
  static bool     longFired = false;   // this hold already acted; ignore its release

  // A stale link ABANDONS the press in progress rather than letting it fall through as a
  // release. Treating the drop as a release would change mode every time the link
  // hiccuped with the button down — the rover would come back from a dropout in STRAFE.
  // A gesture is only a gesture if we watched both of its edges.
  if (!linkFresh) { lastDown = false; longFired = false; return; }

  // A two-stick handheld has nothing to select — its mapping is fixed (see the
  // secondary-stick block) — so DRIVE/STRAFE are one-stick machinery and the mode is
  // pinned to DRIVE while aux is present. The mode may have been left in STRAFE by a
  // one-stick session, and a mode dot that changes nothing would lie. WHEELTEST is not
  // pinned away: it is a bench diagnostic entered by reflash and must survive pairing.
  if (remoteHasAux && driveMode == MODE_STRAFE) {
    driveMode = MODE_DRIVE;
    Serial.println("[mode] DRIVE (two-stick handheld — mode cycle disabled)");
  }

  bool down = (remoteBtns & (uint16_t)(1u << MODE_BUTTON)) != 0;

  if (down && !lastDown) {                                        // ── press
    pressMs   = now;
    longFired = false;
  } else if (down && !longFired && (now - pressMs) >= LONGPRESS_MS) {   // ── held
    // Fires while the button is STILL DOWN, deliberately: the matrix changes under your
    // thumb, so the hold confirms itself and you know to let go. A long press that only
    // acted on release would be indistinguishable from a click until it was over.
    //
    // Only the two cycled modes can be locked. WHEELTEST ignores both sticks, so a lock
    // there would be invisible and would then cost an extra click to clear.
    if (driveMode < MODE_CYCLE_COUNT) throttleLock = true;
    longFired = true;
    Serial.println("[mode] THROTTLE LOCK (hold)");
  } else if (!down && lastDown && !longFired) {                   // ── release of a click
    // The click does ONE thing, in priority order, so it is always exactly one step back
    // toward plain DRIVE:
    //   1. locked          -> clear the lock, stay in the mode. The click is spent on the
    //                         escape and does NOT also cycle — the same rule the off-cycle
    //                         mode has always had, and it is what keeps "one click is the
    //                         way out of wherever a gesture put you" true now that a
    //                         gesture can leave you somewhere without changing the mode.
    //   2. off-cycle mode  -> back to DRIVE (WHEELTEST) rather than wrapping.
    //   3. otherwise       -> cycle DRIVE <-> STRAFE, modulo MODE_CYCLE_COUNT.
    // The lock therefore does NOT survive a mode change, which is deliberate: carrying it
    // across a cycle would mean a click could leave you with a dead throttle in a mode you
    // just arrived in, and the whole point of the click is that it always simplifies.
    if (throttleLock)                       throttleLock = false;
    else if (driveMode >= MODE_CYCLE_COUNT) driveMode = MODE_DRIVE;
    else if (remoteHasAux)                  { /* two sticks: nothing to cycle to */ }
    else                                    driveMode = (driveMode + 1) % MODE_CYCLE_COUNT;
    Serial.print("[mode] ");
    Serial.print(driveMode == MODE_DRIVE ? "DRIVE" : driveMode == MODE_STRAFE ? "STRAFE"
                                                                              : "WHEELTEST");
    Serial.println(throttleLock ? " +lock" : "");
  }
  lastDown = down;
}

// ── Drive tick ────────────────────────────────────────────────────────────────
// Classify the commanded motion from the axes rather than from the wheel values: with
// mecanum the wheel signs alone no longer identify the motion (a strafe and a rotate can
// drive the same wheel the same way).
const char* dirName(int vy, int vx, int w) {
  const int dz = MIN_PWM - 1;
  if (abs(vy) <= dz && abs(vx) <= dz && abs(w) <= dz) return "STOP";
  if (abs(vx) >= abs(vy) && abs(vx) >= abs(w))        return vx > 0 ? "STRAFE-R" : "STRAFE-L";
  if (abs(w)  >= abs(vy))                             return w  > 0 ? "RIGHT" : "LEFT";
  return vy > 0 ? "FORWARD" : "REVERSE";
}

void driveTick(bool linkFresh, uint32_t now) {
  int vy = 0, vx = 0, w = 0;              // forward(+), strafe-right(+), rotate-right(+)

  if (linkFresh) {
    // The N1 pre-mixes its drive stick into tank values, so undo that before re-mixing
    // for mecanum — otherwise the two mixers fight and a strafe comes out as a turn.
    int thr  = axisDead((remoteL + remoteR) / 2);
    int turn = axisDead((remoteL - remoteR) / 2);
    // vx keeps the meaning declared above — +vx = the rover slides RIGHT — everywhere.
    // The chassis's roller orientation is compensated for in the mix via VX_SIGN, NOT
    // here: the matrix dot and dirName() both read vx raw, so a negation at this point
    // would mirror the display against the actual motion.
    if (remoteHasAux) {
      // TWO STICKS — the mapping is FIXED and mode-independent (see the secondary-stick
      // block): primary = throttle + rotate, aux = throttle + strafe. All three DOFs
      // live at once; the throttle axis is shared and sums. The aux axes are taken
      // exactly as the protocol defines them (+X = right, +Y = up, -255..255): no sign
      // flip, no swap, no rescale — see the axis-convention note above for why none of
      // that belongs on this side. clampAxis() on the raw input is the malformed-frame
      // guard.
      int ax = axisDead(clampAxis(remoteAuxX));
      int ay = axisDead(clampAxis(remoteAuxY));
      vy = thr + ay; vx = ax; w = turn;
    } else switch (driveMode) {
      // ONE STICK — the mode says which pair of DOFs its two axes span.
      case MODE_STRAFE: vy = thr; vx = turn; w = 0;    break;   // drive + slide sideways
      default:          vy = thr; vx = 0;    w = turn; break;   // MODE_DRIVE
    }
    // THROTTLE LOCK, applied here and nowhere else: after every source of throttle has
    // been summed, so it means "no forward motion can be commanded" rather than "the drive
    // stick's throttle is ignored". DRIVE + lock is the old MODE_ROTATE exactly: vy = 0
    // with w still live.
    if (throttleLock) vy = 0;
    // Both sticks can push the throttle axis, so re-clamp before anything downstream reads
    // these — the mix, the matrix dot and dirName() all assume -255..255.
    vy = clampAxis(vy); vx = clampAxis(vx); w = clampAxis(w);
  }
  // else: no fresh frame — every axis stays 0 and the slew below ramps the rover down.
  // This is the failsafe, and it is the only one: unlike the Uno Q build there is no vision
  // path that a silent remote can hand control to.

  // Mecanum mix, per wheel. Sign errors here are normal on first bring-up and show up as
  // a strafe that rotates or goes the wrong way — fix with VX_SIGN, not the `inv` flags.
  const int sx = VX_SIGN * vx;
  int wheel[4];
  wheel[0] = vy + sx + w;                 // front-left
  wheel[1] = vy - sx + w;                 // rear-left
  wheel[2] = vy - sx - w;                 // front-right
  wheel[3] = vy + sx - w;                 // rear-right

  // Scale all four down together on overflow. Clamping each wheel independently would
  // distort the ratio between them, which IS the commanded direction — the rover would
  // curve away whenever a combined command saturated.
  int mx = 0;
  for (int i = 0; i < 4; i++) if (abs(wheel[i]) > mx) mx = abs(wheel[i]);
  if (mx > 255) for (int i = 0; i < 4; i++) wheel[i] = wheel[i] * 255 / mx;

  // Wheel identification overrides the mix entirely (both sticks are ignored). Runs with or
  // without a link: it is a bench diagnostic, not a driving mode. Drives each wheel FORWARD
  // in MOTORS[] index order — {FL, RL, FR, RR} — one at a time, so the test answers two
  // questions at once: WHICH corner an index actually drives (compare against the lit
  // matrix quadrant), and whether that corner's `inv` flag is right (does it go forward).
  int testIdx = -1;
  if (driveMode == MODE_WHEELTEST) {
    uint32_t slot = (now / WHEELTEST_MS) % 4;
    bool     spin = (now % WHEELTEST_MS) < WHEELTEST_SPIN_MS;
    testIdx = (int)slot;
    for (int i = 0; i < 4; i++)
      wheel[i] = (spin && i == (int)slot) ? WHEELTEST_PWM : 0;
  }

  // Ramp each wheel toward its target (smooth accel/brake; avoids instant full reversals
  // and the current spikes that come with them). Matrix and motors both come from the
  // same ramped values.
  //
  // The wheel test BYPASSES the ramp, and must. The limiter moves every wheel at most
  // SLEW_STEP per tick, so at a slot boundary the outgoing wheel is still winding down
  // (~350 ms) while the incoming one winds up — two wheels turning at once, in a test whose
  // entire purpose is that exactly one does. A diagnostic that cannot keep its own promise
  // is worse than none, and there is nothing to protect here anyway: it is one unloaded
  // wheel going from 0 to one direction, never a reversal.
  for (int i = 0; i < 4; i++) {
    int target = stallComp(wheel[i]);
    curPwm[i]  = (testIdx >= 0) ? target : slew(curPwm[i], target);
  }
  drive4(curPwm);

  // Announce each slot once, naming the corner the code BELIEVES it is driving, so the
  // serial log is a record of the mapping evidence rather than something you have to be
  // watching the panel to interpret.
  if (testIdx >= 0) {
    static int lastSlot = -1;
    static bool lastSpin = false;
    bool spinning = curPwm[testIdx] != 0;
    if (testIdx != lastSlot || spinning != lastSpin) {
      if (spinning) {
        Serial.print("[wheeltest] "); Serial.print(testIdx);
        Serial.print(" -> "); Serial.print(WHEEL_NAMES[testIdx]);
        Serial.print("  forward @"); Serial.print(curPwm[testIdx]);
        Serial.println(" - watch which wheel turns, and which way");
      } else {
        Serial.println("[wheeltest] (all stopped)");
      }
      lastSlot = testIdx; lastSpin = spinning;
    }
  }

  // Report on change, so the serial log shows what was commanded without a running
  // stream. The large-per-wheel-change trigger is there to settle the "is this veer
  // commanded?" question: if the rover wanders while these values hold steady, the cause
  // is mechanical or electrical (traction, a weak motor, a marginal connection); if the
  // values move with it, it is coming down the wire.
  static const char* lastDir = "";
  static bool     lastFresh  = false;
  static uint8_t  lastMode   = 0xff;
  static bool     lastLock   = false;
  static int      lastW[4]   = {0, 0, 0, 0};
  bool wheelJumped = false;
  for (int i = 0; i < 4; i++) if (abs(curPwm[i] - lastW[i]) >= 30) wheelJumped = true;
  const char* dir = (testIdx >= 0) ? "WHEELTEST" : dirName(vy, vx, w);
  // The lock is in the change trigger as well as the payload: it takes an axis away, so it
  // must appear in the log at the moment it happens rather than being inferred later from
  // a throttle that never moves.
  //
  // Suppressed during the wheel test: [wheeltest] above already reports every slot, and
  // says which corner it believes it is driving, which is the whole point. Two lines per
  // transition would just make the mapping evidence harder to read.
  if (testIdx < 0 && (dir != lastDir || linkFresh != lastFresh || driveMode != lastMode
      || throttleLock != lastLock || wheelJumped)) {
    Serial.print("[drive] "); Serial.print(dir);
    Serial.print(" mode="); Serial.print(driveMode);
    if (throttleLock) Serial.print(" LOCK");
    if (remoteHasAux) Serial.print(" aux");
    Serial.print(" link="); Serial.print(linkFresh ? pairLabel : "none");
    if (testIdx >= 0) { Serial.print(" wheel="); Serial.print(testIdx); }
    Serial.print(" w=");
    for (int i = 0; i < 4; i++) { Serial.print(curPwm[i]); Serial.print(i < 3 ? ',' : ' '); }
    Serial.println();
    lastDir = dir; lastFresh = linkFresh; lastMode = driveMode; lastLock = throttleLock;
    for (int i = 0; i < 4; i++) lastW[i] = curPwm[i];
  }

  // Display ownership is split with loop(): a rover that is SEARCHING shows the search
  // sweep, which loop() draws because only it knows which transport is being probed.
  // Drawing the X here as well would have the two fighting every pass, defeating
  // fbRender()'s identical-frame skip and flickering the panel.
  //
  // A critically low pack outranks everything except the wheel test — the pack is the one
  // condition the operator cannot infer from the rover's behaviour, and the rover keeps
  // driving regardless (indicator-only), so the panel is the only place it can be said.
  // The wheel test still wins because it is a bench diagnostic whose whole purpose is the
  // corner it lights, and it runs with the motors on a timer rather than under command.
  if (testIdx >= 0)     showWheelTest(testIdx);
  else if (battCrit)    showBattery(battPct);
  else if (linkFresh)   showDir(vy, vx, w, linkState == PAIRED_BLE, driveMode, throttleLock,
                                battPct, battState >= 0, battWarn);
  else if (isPaired())  drawNoSignal();            // paired but silent -> "no signal"
}

// ── Setup / loop ──────────────────────────────────────────────────────────────
void setup() {
  Serial.begin(115200);
  for (int i = 0; i < 4; i++) {
    pinMode(MOTORS[i].in1, OUTPUT);
    pinMode(MOTORS[i].in2, OUTPUT);
    pinMode(MOTORS[i].en,  OUTPUT);
  }
  stopMotors();

  matrix.begin();
  // Boot self-test, as the Uno Q build does: light every pixel briefly. Worth the 400 ms
  // because every other screen here is sparse — a dead row or a stuck pixel would
  // otherwise read as a mode dot, a link lamp, a battery bar or a stick position that
  // isn't there.
  memset(fb, 1, sizeof(fb));
  matrix.renderBitmap(fb, PANEL_ROWS, PANEL_COLS);
  delay(400);
  haveLast = false;            // fbRender()'s cache never saw this frame
  drawNoSignal();

  if (ina.begin()) {           // UPS_3S on A4/A5; absent is non-fatal by design
    battReady = true;
    Serial.println("[batt] INA219 @ 0x41 online");
  } else {
    Serial.println("[batt] INA219 not found - battery indicator disabled");
  }

  if (WiFi.status() == WL_NO_MODULE) {
    Serial.println("WiFi/BLE module not found!");
    while (true) { drawNoSignal(); delay(1000); }
  }
  Serial.println("=== r4_mecanum_base - Nesso dual-link mecanum rover ===");
  Serial.println("Searching for a remote over Wi-Fi (UDP/TCP) and BLE, alternating");
  Serial.println("(the R4's radio can't do both at once). First valid frame wins.");

#if ENABLE_BLE
  if (preferBle) { linkState = SEARCH_BLE;  enterBle(); }
  else           { linkState = SEARCH_WIFI; enterWifi(); }
#else
  linkState = SEARCH_WIFI; enterWifi();
#endif
  stateEnteredMs = millis();
}

void loop() {
  // 1) Service the radio every pass. No delay() anywhere in here: the N1 transmits at
  //    ~10 Hz and a blocking wait long enough to matter drops datagrams and starves BLE.
  switch (linkState) {
    case SEARCH_WIFI: pollWifiFrames();  break;
    case SEARCH_BLE:  pollBleSearch();
                      if (bleReadyDbg()) pollBleConnected();  break;
    case PAIRED_WIFI: pollWifiFrames();  break;
    case PAIRED_BLE:  pollBleConnected(); break;
  }

  // SAMPLE THE CLOCK *AFTER* THE POLL — never before it. acceptFrame() runs inside the
  // poll above and stamps `lastFrameMs = millis()`, so a `now` taken before it can be
  // EARLIER than lastFrameMs. These are uint32_t, so `now - lastFrameMs` then underflows
  // to ~4.29e9 — which reads as "no frame for 49 days" and trips the UNPAIR_MS branch
  // below on the very frame that just paired the link.
  //
  // Observed on hardware 2026-08-06 before this was moved: the R4 pair/unpaired at the
  // N1's own 10 Hz frame rate (436 cycles in 45 s), never staying paired long enough to
  // drive. It looked like a flaky BLE link and was not one — and it survived because
  // SEARCH_BLE <-> PAIRED_BLE does not cross the Wi-Fi/BLE domain, so gotoState() never
  // tore the radio down and the next frame simply re-paired. The same underflow reaches
  // stateEnteredMs (set by acceptFrame too), which is why one timestamp covers both.
  uint32_t now = millis();

  // STALL DETECTOR. Anything that blocks loop() for longer than FAILSAFE_MS drops the link
  // without explanation, so make it self-reporting instead of a mystery. Transport
  // hand-offs legitimately block for seconds and stop the motors first, so they are
  // excluded by gotoState() resetting the reference.
  if (stallRefMs && (uint32_t)(now - stallRefMs) > STALL_WARN_MS) {
    Serial.print("[stall] loop blocked "); Serial.print(now - stallRefMs);
    Serial.println(" ms - link may drop");
  }
  stallRefMs = now;

  // Battery is polled outside the drive tick: it is rate-limited internally to 1 Hz and
  // its I2C transaction is short, so it costs nothing here and keeps sampling while the
  // link is down — which is exactly when a pack is most likely to be running flat.
  pollBattery(now);

  bool paired    = isPaired();
  bool linkFresh = paired && haveFrame && (now - lastFrameMs) < FAILSAFE_MS;

  // 2) Drive on a fixed tick, so SLEW_STEP stays "max PWM change per 60 ms". Runs while
  //    searching too — with linkFresh false the axes are zero, which both ramps a rover
  //    that just lost its link down to a stop and keeps MODE_WHEELTEST usable on the
  //    bench with no remote present at all.
  static uint32_t lastDriveMs = 0;
  if (now - lastDriveMs >= DRIVE_TICK_MS) {
    lastDriveMs = now;
    updateMode(linkFresh, now);
    driveTick(linkFresh, now);
  }

  // 3) State transitions. The drive tick above has already stopped the rover for any
  //    transition reachable from here, and gotoState() stops it again before taking the
  //    radio down — the transport swap blocks for seconds and nothing services the tick
  //    while it does.
  if (paired) {
    if (!linkFresh && (now - lastFrameMs) > UNPAIR_MS) {
      haveFrame = false;
      Serial.println("[link] lost - re-entering search");
      gotoState(linkState == PAIRED_BLE ? SEARCH_BLE : SEARCH_WIFI);
    }
  } else {
    heartbeat();
    // Skip the sweep for anything driveTick() already drew this pass, or the two fight
    // every loop and defeat fbRender()'s identical-frame skip. Both of those screens
    // outrank "still searching": the wheel test is why the rover is on the bench, and a
    // critical pack is the one thing the operator cannot infer from its behaviour.
    if (driveMode != MODE_WHEELTEST && !battCrit) drawSearch(linkState == SEARCH_BLE);
#if ENABLE_BLE
    // Bail out of a BLE window whose BLE.begin() failed instead of sitting out its full
    // dwell: there is no stack to scan, and Wi-Fi — which still works — is where a remote
    // could actually be heard. Going back through gotoState() re-enters Wi-Fi properly and
    // leaves the next BLE window to retry, so a transient failure costs one hand-off
    // rather than every other search window.
    if (linkState == SEARCH_BLE && !bleBegunDbg()) gotoState(SEARCH_WIFI);
    else if (now - stateEnteredMs > searchWindowMs()) {
      // This window produced no frame. Count it: once both transports have had a turn the
      // preference stops applying and each gets a full dwell (see searchWindowMs()).
      if (searchRounds < 255) searchRounds++;
      gotoState(linkState == SEARCH_WIFI ? SEARCH_BLE : SEARCH_WIFI);
    }
#else
    // Wi-Fi-only: if the connect failed (no IP), keep retrying until it lands — there is
    // no BLE phase to fall through to that would otherwise re-enter Wi-Fi.
    if (WiFi.status() != WL_CONNECTED || WiFi.localIP() == IPAddress(0, 0, 0, 0)) {
      stopMotors();
      enterWifi();
      stateEnteredMs = now;
    } else if (now - stateEnteredMs > searchWindowMs()) {
      stateEnteredMs = now;
    }
#endif
  }
}
