ugursayar/r4_mecanum_base/(commit log)

2026-08-06 feat: Nesso-driven mecanum rover on an Uno R4 WiFi
    Ports quali_base's mecanum drive logic from the Uno Q onto a bare R4, which
    has no companion Linux MPU — so this sketch owns the radio itself, accepting
    NessoLink RemoteFrames over Wi-Fi (UDP + TCP) and BLE and auto-pairing with
    whichever remote speaks first. The dual-link state machine comes from
    examples/Nesso_R4_Receiver.
    Carried over with behaviour intact: the axis dead-zone and stall-compensation
    split placed on opposite sides of the mecanum mix, the per-wheel mixer and its
    proportional down-scale on overflow, the slew limiter, REMOTE_DEADBAND = 25,
    the click/long-press gestures, the throttle lock, the secondary stick, and
    MODE_WHEEL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
    [r4_mecanum_base.ino]
2026-08-06 fix: sample millis() after the transport poll, not before it
    Found on hardware: the R4 pair/unpaired at the N1's own 10 Hz frame rate --
    436 cycles in 45 s -- and never stayed paired long enough to drive a wheel.
    loop() sampled `now = millis()` above the poll switch, but acceptFrame()
    runs inside that poll and stamps lastFrameMs = millis(). So lastFrameMs
    could exceed now, and since both are uint32_t the `now - lastFrameMs`
    subtraction underflowed to ~4.29e9 -- read as "no frame for 49 days", which
    tripped the UNPAIR_MS branch on the very frame that had just paired the
    link. The same underflow reaches stateEnteredMs, which acceptFrame() also
    stamps, so one correctly placed timestamp fixes b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
    [r4_mecanum_base.ino]
2026-08-06 feat(matrix): portrait 90deg CW layout, and port the UPS_3S pack monitor
    Rotate the panel into a logical PORTRAIT frame and band it, so the top and
    bottom rows become dedicated status strips.
    Every draw routine now works in a logical 8 wide x 12 tall frame with (0,0)
    at the viewer's top-left, and px() applies the rotation on the way out --
    the same arrangement quali_base uses, so an indicator ported from there
    keeps its geometry and only the height constant changes. Nothing above
    fbRender() touches the framebuffer directly any more.
    y = 0 STATUS -- link lamp (x0 Wi-Fi, x1 BLE) + mode dots from the
    right edge
    y = 2..H-3 STICK -- the proportional dot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
2026-08-06 feat(wheeltest): make it usable, then calibrate MOTORS[] against it
    The wheel test existed but could not keep its own promise. The slew limiter
    moves every wheel at most SLEW_STEP per tick, so at each slot boundary the
    outgoing wheel was still winding down (~350 ms) while the incoming one wound
    up -- two wheels turning at once, in a test whose entire purpose is that
    exactly one does. It now bypasses the ramp: there is nothing to protect,
    being one unloaded wheel going 0 -> forward, never a reversal.
    Each 2 s slot is now 1.4 s spinning and 0.6 s completely still. The gap is
    not padding. Without it you are watching for the instant one wheel stops and
    the next starts, and between FL and RL --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
    [r4_mecanum_base.ino]
2026-08-06 docs: replace the stale pin-map section in CLAUDE.md
    It still described the pre-calibration assignment (EN on D3/D5/D6/D9,
    direction pins on A0-A2) and contradicted the rest of the file after the
    map moved to quali_base's. Replaced with the wired table, the opposite
    channel conventions of the two modules, and the note that the PWM pin set
    was confirmed in the UNOWIFIR4 variant rather than assumed.
2026-08-06 fix(mix): VX_SIGN = -1, measured -- the rollers are mirrored
    Strafe slid the opposite way to the command, so the chassis's rollers are
    mirrored against the standard X layout the mix assumes (viewed from above,
    top rollers forming an X: FL/RR at +45, FR/RL at -45). quali_base is
    mirrored the same way and carries the same negation, which is unsurprising
    for the same chassis design.
    The bring-up order is what makes this attributable to the rollers rather
    than to wiring. By this point the wheel test had confirmed the corner
    mapping and forward already tracked straight with inv calibrated, so nothing
    about which motor is which could still be wrong -- only the diagonal the
    rollers push along was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
    [r4_mecanum_base.ino]
2026-08-06 docs: an empty battery gauge on USB is expected, not an open fault
    The UPS is switched off whenever USB is connected, so the INA219 is
    unpowered and reports "no sensor" on every bench run. Both docs recorded
    that as an outstanding problem, which would have sent someone hunting a
    wiring fault that does not exist.
    No code change: pollBattery() already re-probes every BATT_RETRY_MS (5 s)
    while the module is absent, so it joins by itself on a pack-powered run --
    or if the pack is switched on mid-run -- with no reset. Also note that the
    matrix gauge row is the only readout there, since a pack-powered run has no
    serial.
    Also refresh the confirmed/not-confirmed list, which still predated the
    moto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
2026-08-06 docs: record that full stick is a true 100% duty, and what limits power
    Answers a question worth not having to re-derive: at MAX_PWM = 255 the EN
    pin sits continuously HIGH, not at 254/255. Traced through the R4 core
    rather than assumed -- analogWrite(255) becomes pulse_perc(100.0) ->
    set_duty_cycle(period), compare equal to period, so there is no low phase.
    Default PWM is 490 Hz (STANDARD_PWM_FREQ_HZ), fine for an L298N.
    MAX_PWM therefore has no headroom left; there is nothing above it to raise.
    Both docs now separate the two voltages that get conflated here: EN is a 5 V
    logic enable, while motor current comes from the L298N's Vs rail -- the
    12.6 V pack -- never from the Arduino. The class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
2026-08-06 fix(wifi): stop polling TCP, and make the transport switch work at all
    Switching the N1 from BLE to Wi-Fi UDP did not reconnect until the R4 was
    power-cycled. Three separate faults, all found on hardware.
    1. WiFiServer::available() blocks ~10 s per call.
    It is not a cheap poll: it is a synchronous modem round-trip that performs
    the accept on the ESP32-S3, so with no client pending it waits out the
    modem's timeout -- measured at ~10.1 s on this board, every loop pass, i.e.
    14x FAILSAFE_MS. The symptom was not "TCP is slow" but "Wi-Fi is unusable":
    the drive loop stopped for 10 s, the link went stale, the rover stopped,
    unpaired, re-paired on the next buffered datagram and did it again 10 s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
    [r4_mecanum_base.ino]
2026-08-06 docs: record the transport switch as verified on the real N1
    The three Wi-Fi fixes in a66dd81 were verified on the bench with the
    synthetic transmitter, but the docs still described switching between BLE
    and Wi-Fi UDP as fixed-in-principle. It has now been exercised on hardware
    with the real handheld, in both directions, re-pairing on its own with no
    power cycle -- which is the case those fixes exist for and the one that
    could not be reproduced with nesso_tx.py alone.
    Also record that UDP is confirmed twice over and by what: the synthetic
    --pattern idle stream on the bench (centred sticks, so decode and pairing
    are exercised without commanding motion -- the right tool once the motors
    are wi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
2026-08-11 fix(mix): VX_SIGN = +1 -- re-measured after the wheels moved to their right corners
    The -1 measured on 2026-08-06 was an artifact: the mecanum wheels were
    mounted in the wrong corners, which mirrors the roller pattern the chassis
    presents. Remounting them correctly inverted the strafe and nothing else --
    forward is invariant to roller orientation and rotation needed no change,
    which is exactly a roller-pattern flip and not a wiring fault. With the
    wheels right, this chassis IS the standard X layout.
    The old "this chassis's rollers are mirrored by design" story is gone from
    the comment, and quali_base's -1 -- same chassis, same wheels -- is flagged
    as suspect until re-verified on hardware. R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
    [r4_mecanum_base.ino]
2026-08-11 feat(drive): two sticks get a FIXED mapping; modes become one-stick machinery
    The aux stick used to drive whichever mode was NOT selected (auxModeFor()),
    so the sticks swapped roles when the mode changed. Same reachable motions,
    but what a stick did depended on a dot on the matrix, and the swap bought
    nothing over a fixed mapping. Now, with hasAux set:
    primary (seesaw) throttle + rotate -> vy, w
    secondary (aux 1) throttle + strafe -> vy, vx
    All three DOFs are live at once, so every motion -- diagonals, strafe, and
    all four rotation types including the axle pivots -- is available by
    default with no mode change. Modes exist only because ONE stick cannot
    span three DOFs, so with two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
    [r4_mecanum_base.ino]
2026-08-11 docs: mecanum motion reference -- the standard charts, and the four rotations
    Adds the classic 8-panel motion chart and the wheel-principle infographic
    to images/, and a README section reading them against this sketch's mix:
    every motion falls out of the same four mix lines with no special cases,
    and the bottom row is four DISTINCT rotation types -- spin in place,
    around a bend, and the two axle pivots. The pivots work because equal
    strafe + rotate cancels one wheel pair exactly, which also means they need
    vx and w at once: a one-stick remote can never reach them, the concrete
    payoff of the two-stick holonomy.
2026-08-11 chore(vscode): add Wire to the IntelliSense include path
2026-09-03 docs: crop the mecanum principle chart to just the motion panels
    Keeps the a)-f) motion diagram and its caption; drops the surrounding framing
    (title banner, wheel photo, logo badge) that carried no reference value next to
    the chart already above it in the README. 602x1060 -> 588x428, 485 KB -> 230 KB.
    Note: the framing that was cropped included the embedded "Source: Lesics
    (YouTube)" credit, and README.md carries no attribution of its own.
2026-09-03 chore(vscode): untrack c_cpp_properties.json — it is machine-specific
    Every include path in it is an absolute D:\packages\arduino\... path, plus a
    PROJECT_NAME pointing at a local build-cache directory, so the file is useless
    to anyone else cloning the repo. Kept locally, ignored from now on;
    .vscode/arduino.json stays tracked since board and sketch are portable.
2026-09-03 chore: add .gitattributes, normalise line endings to LF
    core.autocrlf=true with no .gitattributes had already staged one file
    (INA219.h) as CRLF against an LF history. Pin it per-repo instead: text
    files commit as LF, images are marked binary so nothing converts them.
    git add --renormalize . changed no files -- every tracked blob was
    already LF.
2026-09-03 docs: move engineering notes into docs/ENGINEERING.md
    README linked to CLAUDE.md, which is gitignored -- so the link was dead for
    anyone cloning the repo. Move the material README does not already cover into
    a tracked docs/ENGINEERING.md and point the link there.
    Carried across: the .ino prototype-injection trap, MOTORS[] positional order,
    the no-delay/no-volatile/cut-motors-first trio, axisDead vs stallComp, the
    clampAxis malformed-frame guard, the aux-transposition history, the matrix
    draw rules, gesture edge-resolution, the millis() underflow, the ESP32-S3
    modem power-cycle, serial DTR, and the bench confirmed/not-confirmed ledger.
    Left out as already in README: TCP polling, socket bind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
